vicayacan56/Placa_Victor_Ayala_Cano/3Dmodels/UNO Q simplified.STEP

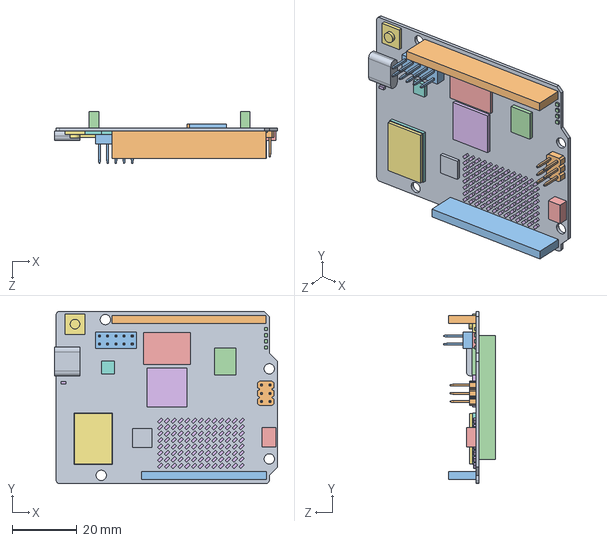
[picture p1: CAD file, 2026-03-18]
3Dmodels/UNO Q simplified.STEP
69.1 x 53.3 x 16.0 mm
