vicayacan56/Placa_Victor_Ayala_Cano/3Dmodels/57PC5FS.step

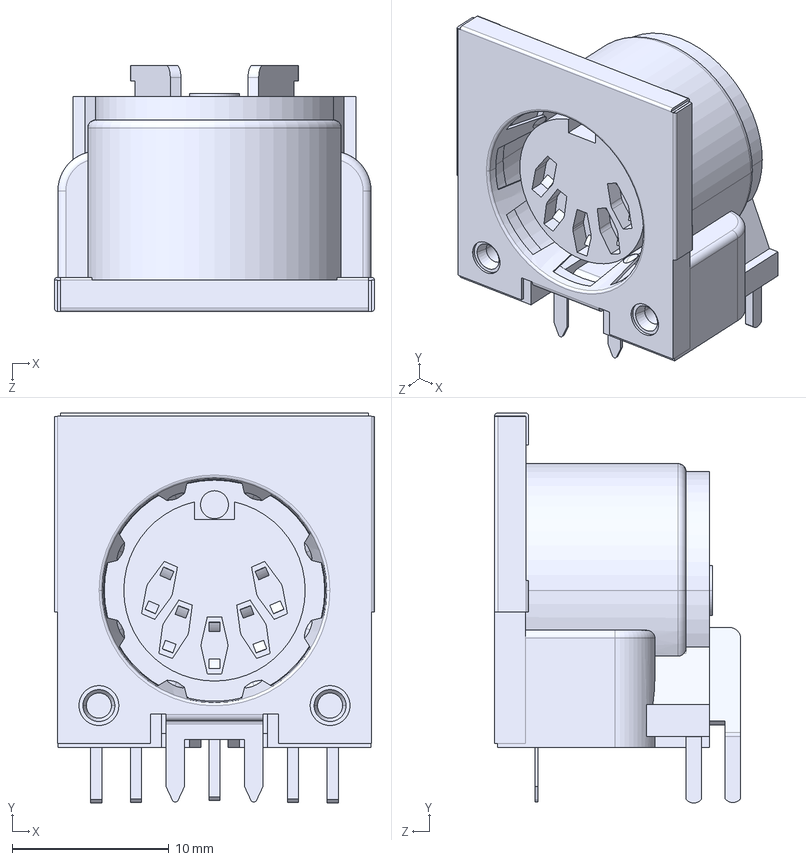
[picture p2: CAD file, 2026-03-18]
3Dmodels/57PC5FS.step
20.4 x 24.9 x 15.7 mm
