vicayacan56/Placa_Victor_Ayala_Cano/Placa_Victor_Ayala_Cano.kicad_pcb

## KiCad design Placa_Victor_Ayala_Cano.kicad_pcb (2026-03-18)

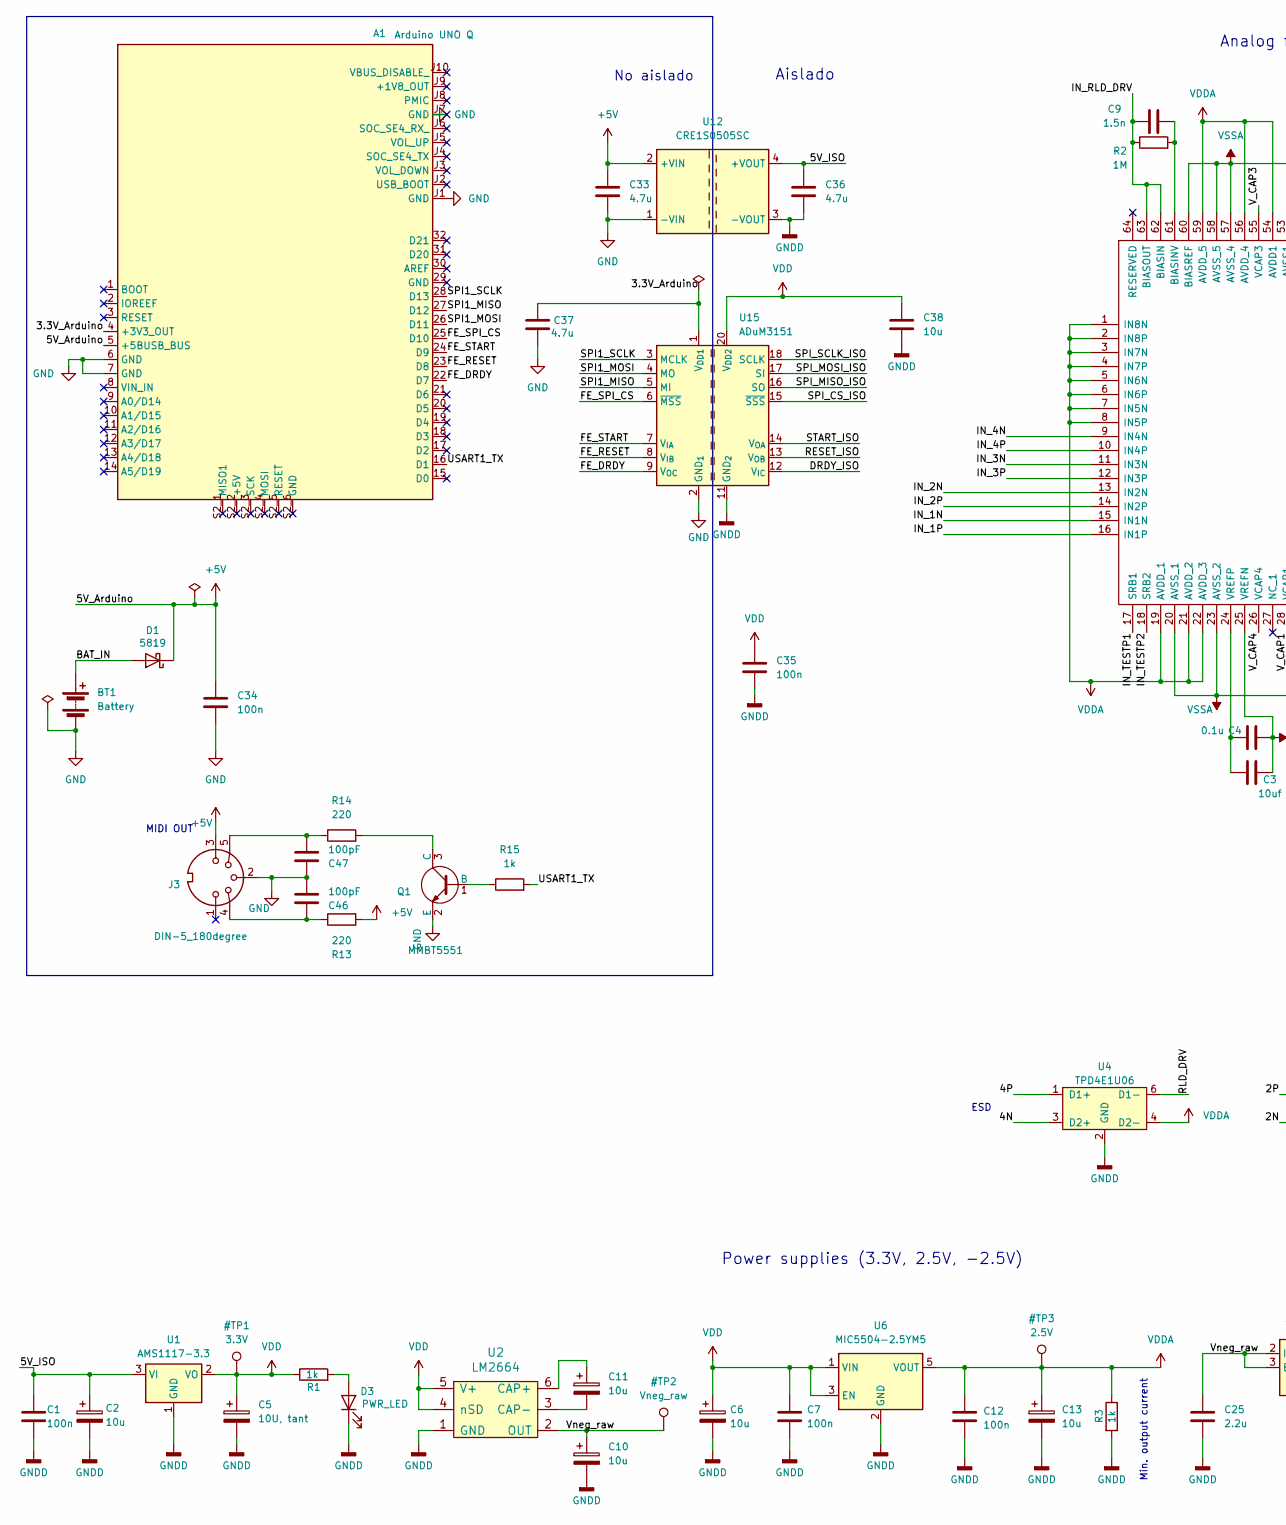
[picture p3: schematic Placa_Victor_Ayala_Cano.kicad_sch, part in row 1, column 1]

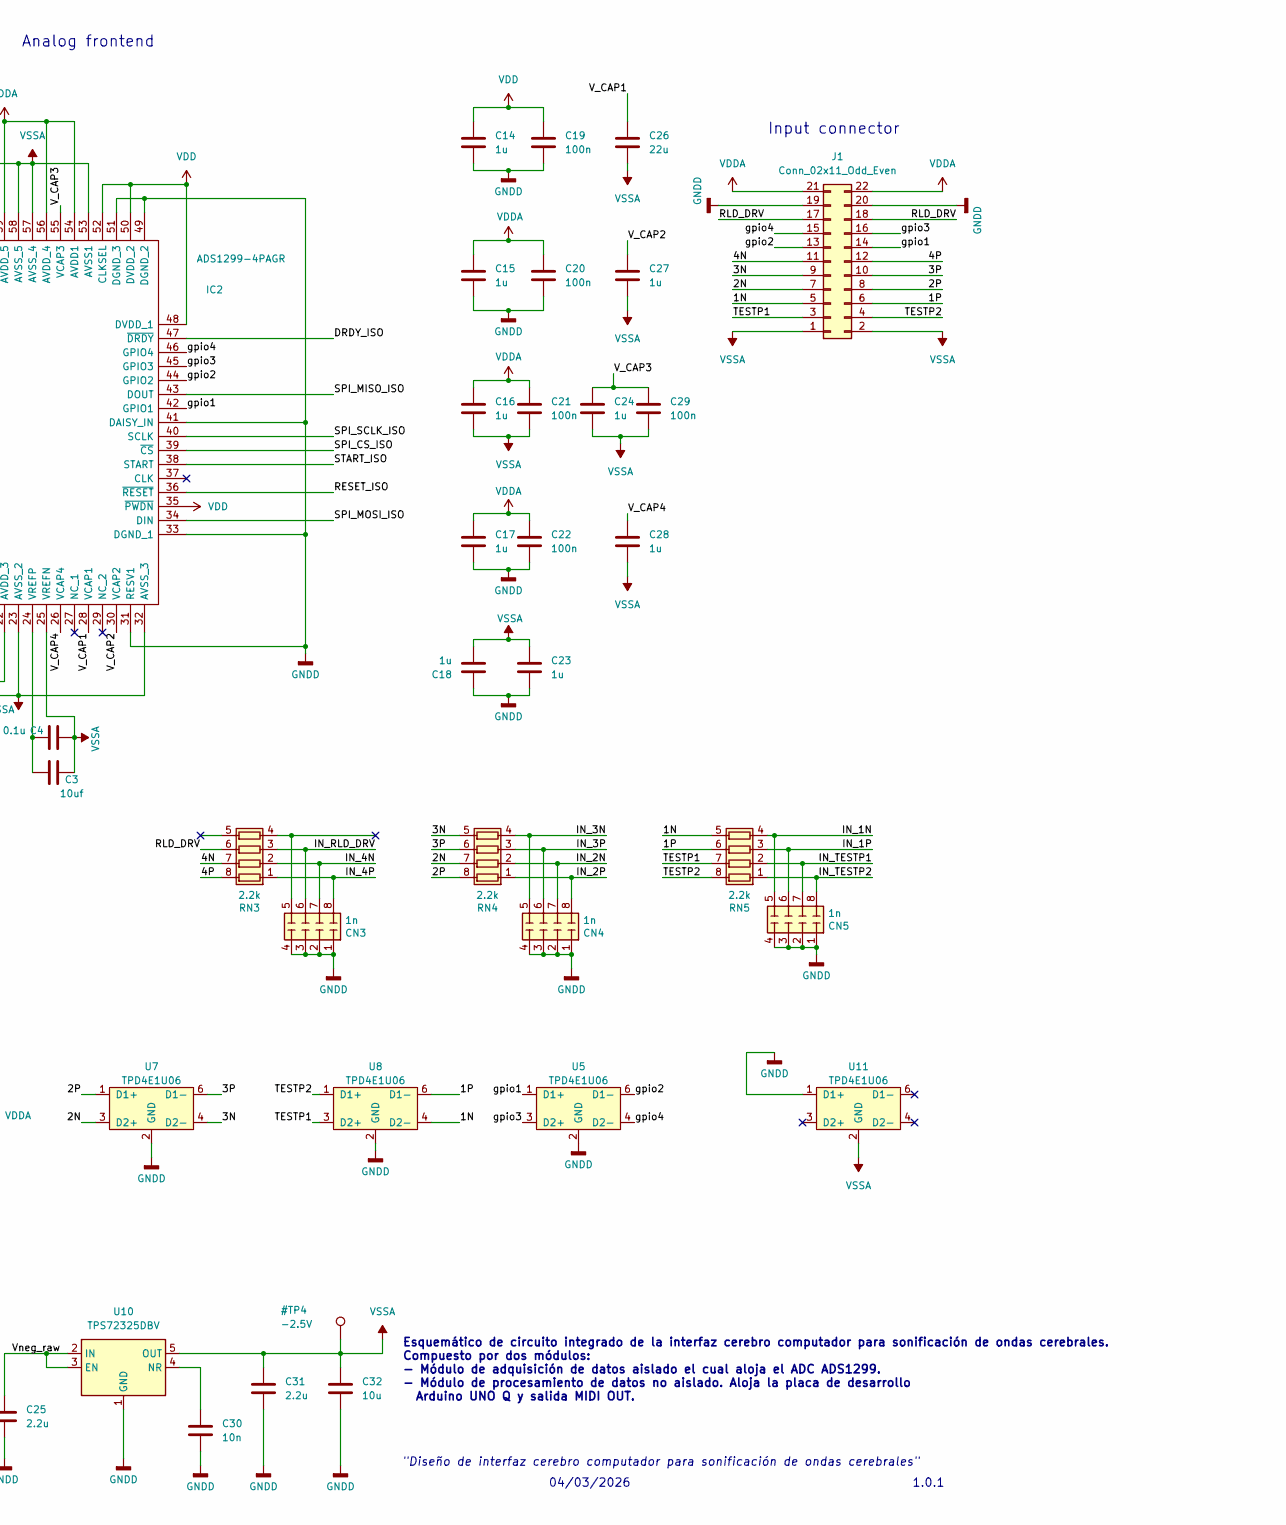
[picture p4: schematic Placa_Victor_Ayala_Cano.kicad_sch, part in row 1, column 2]

Parts:
A1: Arduino UNO Q; Arduino_UNO_R3
BT1: Battery; PinHeader_1x02_P2.54mm_Vertical
C1, C7, C12, C19, C20, C21, C22, C29, C34, C35: 100n; C_0805_2012Metric_Pad1.18x1.45mm_HandSolder
C2, C6, C10, C11, C13, C32, C38: 10u; C_0805_2012Metric_Pad1.18x1.45mm_HandSolder
C3: 10uf; C_0805_2012Metric_Pad1.18x1.45mm_HandSolder
C4: 0.1u; C_0805_2012Metric_Pad1.18x1.45mm_HandSolder
C5: 10U, tant; C_0805_2012Metric_Pad1.18x1.45mm_HandSolder
C9: 1.5n; C_0805_2012Metric_Pad1.18x1.45mm_HandSolder
C14, C15, C16, C17, C18, C23, C24, C27, C28: 1u; C_0805_2012Metric_Pad1.18x1.45mm_HandSolder
C25, C31: 2.2u; C_0805_2012Metric_Pad1.18x1.45mm_HandSolder
C26: 22u; C_0805_2012Metric_Pad1.18x1.45mm_HandSolder
C30: 10n; C_0805_2012Metric_Pad1.18x1.45mm_HandSolder
C33, C36, C37: 4.7u; C_0805_2012Metric_Pad1.18x1.45mm_HandSolder
C46, C47: 100pF; C_0805_2012Metric_Pad1.18x1.45mm_HandSolder
CN3, CN4, CN5: 1n; R_Array_Convex_4x0603; LCSC C507409
D1: 5819; D_SOD-123; LCSC C82544
D3: PWR_LED; LED_0805_2012Metric
IC2: ADS1299-4PAGR; TQFP-64_10x10mm_P0.5mm; Mouser Part Number 595-ADS1299-4PAGR
J1: Conn_02x11_Odd_Even; PinHeader_2x11_P2.54mm_Vertical
J3: DIN-5_180degree; 57PC5FS; Manufacturer_Part_Number 57PC5FS
Q1: MMBT5551; SOT-23; Manufacturer_Part_Number MMBT5551
R1, R3, R15: 1k; R_0805_2012Metric
R2: 1M; R_0805_2012Metric
R13, R14: 220; R_0805_2012Metric
RN3, RN4, RN5: 2.2k; R_Array_Convex_4x0603; LCSC C12001
U1: AMS1117-3.3; SOT-223-3_TabPin2; Manufacturer_Part_Number AMS1117-3.3
U2: LM2664; SOT-23-6; Manufacturer_Part_Number LM2664; LCSC C108573
U4, U5, U7, U8, U11: TPD4E1U06; SOT-23-6; Manufacturer_Part_Number TPD4E1U06; LCSC C124691
U6: MIC5504-2.5YM5; SOT-23-5; Manufacturer_Part_Number MIC5504-2.5YM5
U10: TPS72325DBV; SOT-23-5; Manufacturer_Part_Number TPS72325DBV
U12: CRE1S0505SC; Converter_DCDC_Murata_CRE1xxxxxxSC_THT; Manufacturer_Part_Number CRE1S0505SC
U15: ADuM3151; SSOP-20_5.3x7.2mm_P0.65mm; Manufacturer_Part_Number ADuM3151

Connections:
+5V: A1.5 (+5BUSB_BUS), C33.1, C34.1, D1.1 (K), J3.3, R13.2, U12.2 (+VIN)
/1N: J1.5, RN5.5 (R4.2), U8.4 (D2-)
/1P: J1.6, RN5.6 (R3.2), U8.6 (D1-)
/2N: J1.7, RN4.7 (R2.2), U7.3 (D2+)
/2P: J1.8, RN4.8 (R1.2), U7.1 (D1+)
/3.3V_Arduino: A1.4 (+3V3_OUT), C37.1, U15.1 (V_{DD1})
/3N: J1.9, RN4.5 (R4.2), U7.4 (D2-)
/3P: J1.10, RN4.6 (R3.2), U7.6 (D1-)
/4N: J1.11, RN3.7 (R2.2), U4.3 (D2+)
/4P: J1.12, RN3.8 (R1.2), U4.1 (D1+)
/5V_ISO: C1.1, C2.1, C36.1, U1.3 (VI), U12.4 (+VOUT)
/BAT_IN: BT1.1 (+), D1.2 (A)
/DRDY_ISO: IC2.47 (~DRDY), U15.12 (V_{IC})
/FE_DRDY: A1.22 (D7), U15.9 (V_{OC})
/FE_RESET: A1.23 (D8), U15.8 (V_{IB})
/FE_SPI_CS: A1.25 (D10), U15.6 (~MSS)
/FE_START: A1.24 (D9), U15.7 (V_{IA})
/IN_1N: CN5.5 (R4.2), IC2.15 (IN1N), RN5.4 (R4.1)
/IN_1P: CN5.6 (R3.2), IC2.16 (IN1P), RN5.3 (R3.1)
/IN_2N: CN4.7 (R2.2), IC2.13 (IN2N), RN4.2 (R2.1)
/IN_2P: CN4.8 (R1.2), IC2.14 (IN2P), RN4.1 (R1.1)
/IN_3N: CN4.5 (R4.2), IC2.11 (IN3N), RN4.4 (R4.1)
/IN_3P: CN4.6 (R3.2), IC2.12 (IN3P), RN4.3 (R3.1)
/IN_4N: CN3.7 (R2.2), IC2.9 (IN4N), RN3.2 (R2.1)
/IN_4P: CN3.8 (R1.2), IC2.10 (IN4P), RN3.1 (R1.1)
/IN_RLD_DRV: C9.1, CN3.6 (R3.2), IC2.62 (BIASIN), IC2.63 (BIASOUT), R2.1, RN3.3 (R3.1)
/IN_TESTP1: CN5.7 (R2.2), IC2.17 (SRB1), RN5.2 (R2.1)
/IN_TESTP2: CN5.8 (R1.2), IC2.18 (SRB2), RN5.1 (R1.1)
/RESET_ISO: IC2.36 (~RESET), U15.13 (V_{OB})
/RLD_DRV: J1.17, J1.18, RN3.6 (R3.2), U4.6 (D1-)
/SPI1_MISO: A1.27 (D12), U15.5 (MI)
/SPI1_MOSI: A1.26 (D11), U15.4 (MO)
/SPI1_SCLK: A1.28 (D13), U15.3 (MCLK)
/SPI_CS_ISO: IC2.39 (~CS), U15.15 (~SSS)
/SPI_MISO_ISO: IC2.43 (DOUT), U15.16 (SO)
/SPI_MOSI_ISO: IC2.34 (DIN), U15.17 (SI)
/SPI_SCLK_ISO: IC2.40 (SCLK), U15.18 (SCLK)
/START_ISO: IC2.38 (START), U15.14 (V_{OA})
/TESTP1: J1.3, RN5.7 (R2.2), U8.3 (D2+)
/TESTP2: J1.4, RN5.8 (R1.2), U8.1 (D1+)
/USART1_TX: A1.16 (D1), R15.2
/V_CAP1: C26.1, IC2.28 (VCAP1)
/V_CAP2: C27.2, IC2.30 (VCAP2)
/V_CAP3: C24.1, C29.1, IC2.55 (VCAP3)
/V_CAP4: C28.1, IC2.26 (VCAP4)
/Vneg_raw: C10.1, C25.1, U2.2 (OUT), U10.2 (IN), U10.3 (EN)
/gpio1: IC2.42 (GPIO1), J1.14, U5.1 (D1+)
/gpio2: IC2.44 (GPIO2), J1.13, U5.6 (D1-)
/gpio3: IC2.45 (GPIO3), J1.16, U5.3 (D2+)
/gpio4: IC2.46 (GPIO4), J1.15, U5.4 (D2-)
GND: A1.6 (GND), A1.7 (GND), A1.J1 (GND), A1.J7 (GND), BT1.2 (-), C33.2, C34.2, C37.2, C46.1, C47.2, J3.2, Q1.2 (E), U12.1 (-VIN), U15.2 (GND_{1}), U15.10 (GND_{1})
GNDD: C1.2, C2.2, C5.2, C6.2, C7.2, C10.2, C12.2, C13.2, C14.1, C15.2, C17.2, C18.1, C19.2, C20.2, C22.2, C23.2, C25.2, C30.2, C31.2, C32.2, C35.2, C36.2, C38.2, CN3.1 (R1.1), CN3.2 (R2.1), CN3.3 (R3.1), CN3.4 (R4.1), CN4.1 (R1.1), CN4.2 (R2.1), CN4.3 (R3.1), CN4.4 (R4.1), CN5.1 (R1.1), CN5.2 (R2.1), CN5.3 (R3.1), CN5.4 (R4.1), D3.1 (K), IC2.31 (RESV1), IC2.33 (DGND_1), IC2.41 (DAISY_IN), IC2.49 (DGND_2), IC2.51 (DGND_3), J1.19, J1.20, R3.2, U1.1 (GND), U2.1 (GND), U4.2 (GND), U5.2 (GND), U6.2 (GND), U7.2 (GND), U8.2 (GND), U10.1 (GND), U11.1 (D1+), U12.3 (-VOUT), U15.11 (GND_{2}), U15.19 (GND_{2})
unnamed: C46.2, J3.4, R13.1
unnamed: C47.1, J3.5, R14.1
unnamed: D3.2 (A), R1.2
unnamed: C9.2, IC2.61 (BIASINV), R2.2
unnamed: C3.1, C4.1, IC2.24 (VREFP)
unnamed: Q1.1 (B), R15.1
unnamed: Q1.3 (C), R14.2
unnamed: C11.1, U2.6 (CAP+)
unnamed: C11.2, U2.3 (CAP-)
unnamed: C30.1, U10.4 (NR)
VDD: C5.1, C6.1, C7.1, C14.2, C19.1, C35.1, C38.1, IC2.35 (~PWDN), IC2.48 (DVDD_1), IC2.50 (DVDD_2), IC2.52 (CLKSEL), R1.1, U1.2 (VO), U2.4 (nSD), U2.5 (V+), U6.1 (VIN), U6.3 (EN), U15.20 (V_{DD2})
VDDA: C12.1, C13.1, C15.1, C16.1, C17.1, C20.1, C21.1, C22.1, IC2.1 (IN8N), IC2.2 (IN8P), IC2.3 (IN7N), IC2.4 (IN7P), IC2.5 (IN6N), IC2.6 (IN6P), IC2.7 (IN5N), IC2.8 (IN5P), IC2.19 (AVDD_1), IC2.21 (AVDD_2), IC2.22 (AVDD_3), IC2.54 (AVDD1), IC2.56 (AVDD_4), IC2.59 (AVDD_5), J1.21, J1.22, R3.1, U4.4 (D2-), U6.5 (VOUT)
VSSA: C3.2, C4.2, C16.2, C18.2, C21.2, C23.1, C24.2, C26.2, C27.1, C28.2, C29.2, C31.1, C32.1, IC2.20 (AVSS_1), IC2.23 (AVSS_2), IC2.25 (VREFN), IC2.32 (AVSS_3), IC2.53 (AVSS1), IC2.57 (AVSS_4), IC2.58 (AVSS_5), IC2.60 (BIASREF), J1.1, J1.2, U10.5 (OUT), U11.2 (GND)

Notes on the sheet:
Analog frontend
Min. output current
Power supplies (3.3V, 2.5V, -2.5V)
No aislado
04/03/2026
Input connector
Esquemático de circuito integrado de la interfaz cerebro computador para sonificación de ondas cerebrales. Compuesto por dos módulos: - Módulo de adquisición de datos aislado el cual aloja el ADC ADS1299. - Módulo de procesamiento de datos no aislado. Aloja la placa de desarrollo Arduino UNO Q y sa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
1.0.1
"Diseño de interfaz cerebro computador para sonificación de ondas cerebrales"
MIDI OUT
Aislado
ESD

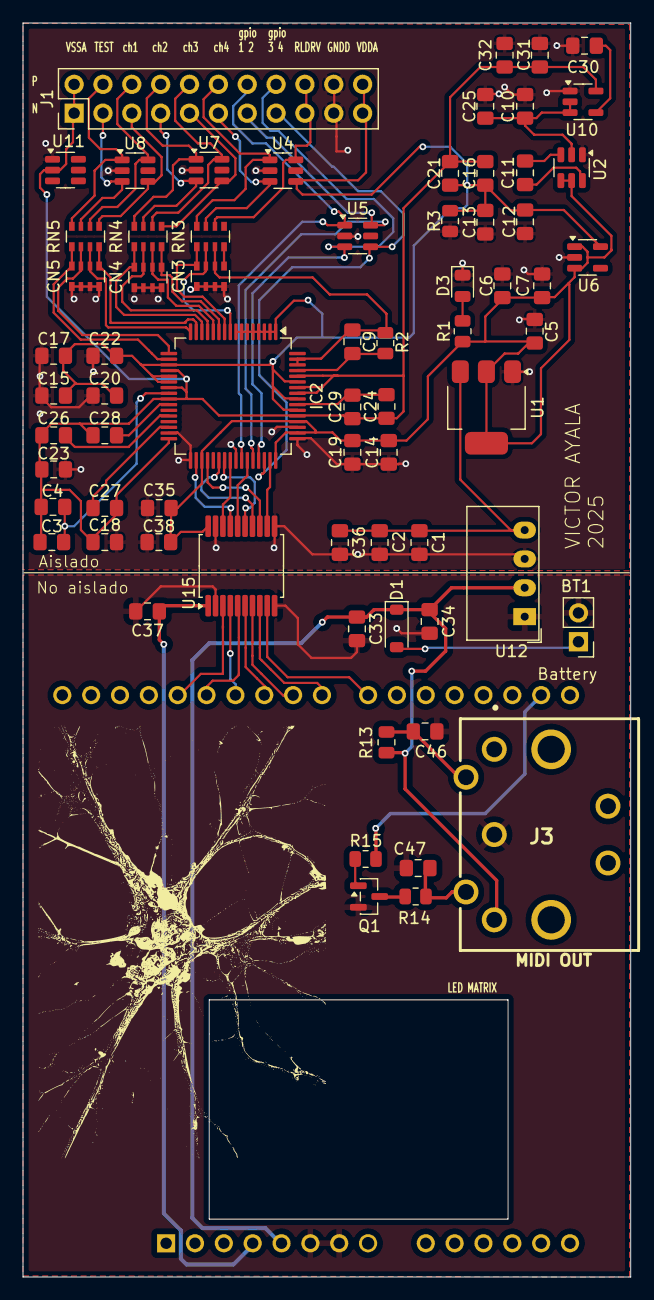
[picture p5: board Placa_Victor_Ayala_Cano.kicad_pcb from above]

Board: 2 copper layers, 53.5 x 110.4 mm, 70 parts (1 on the bottom side), 65 nets.
