vicayacan56/Placa_Victor_Ayala_Cano/(commit log)

2026-03-18 Initial commit - KiCad PCB project
    [Placa_Victor_Ayala_Cano.csv, Placa_Victor_Ayala_Cano.kicad_pcb, Placa_Victor_Ayala_Cano.kicad_sch]
2026-03-18 Update: rutas relativas, modelos 3D y librerías locales
    [57PC5FS.step, Placa_Victor_Ayala_Cano.kicad_pcb, UNO Q simplified.STEP]
